ccchunguiuc/ECE445/pcb/445.kicad_pcb

## KiCad design pcb/445.kicad_pcb (2023-05-04)

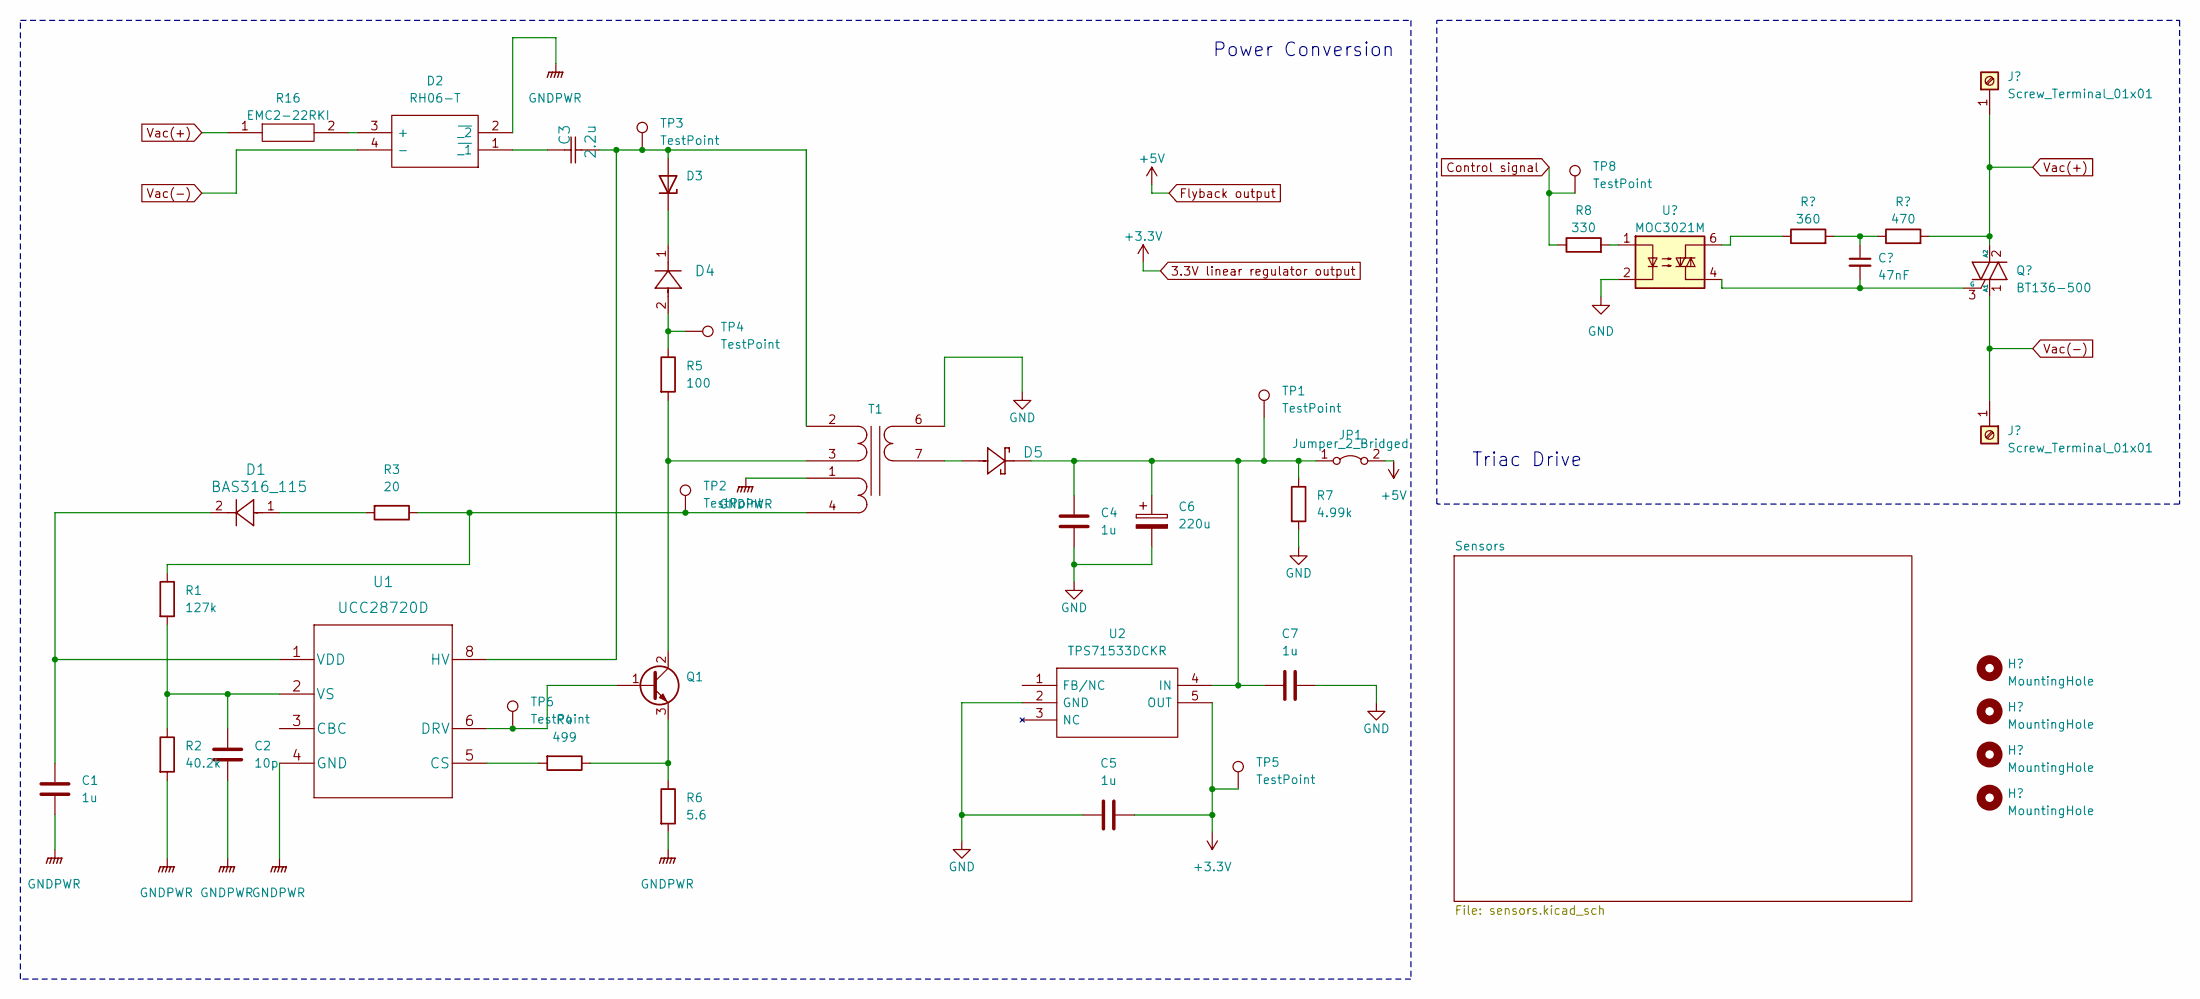
[picture p1: schematic 445.kicad_sch]

Parts:
C1, C4, C5, C7: 1u; C_0603_1608Metric
C2: 10p; R_0603_1608Metric
C3: 2.2u; CKG57NX7T2W225M500JH
C6: 220u; 10TPE220ML
C8: 47nF; C_0603_1608Metric
D1: BAS316_115; SC-76_SOD323_NEX
D2: RH06-T; SOP250P700X300-4N; Mouser Part Number 621-RH06-T
D3: D_Zener; SOD-123_ONS
D4: CGRM4007-G; CGRM
D5: SS110-TP; DO-214AC_SMA_HIGHPROFILE_MCC
H1, H2, H3, H4: MountingHole; MountingHole_3.2mm_M3
J1, J2: Screw_Terminal_01x01; MountingHole_8.0mm_M8_Pad_TopBottom
JP1: Jumper_2_Bridged; R_0603_1608Metric
Q1: Q_NPN_BCE; TO-92L
Q2: BT136-500; TO-220-3_Vertical
R1: 127k; R_0402_1005Metric
R2: 40.2k; R_0603_1608Metric
R3: 20; R_0603_1608Metric
R4: 499; R_0603_1608Metric
R5: 100; R_0805_2012Metric
R6: 5.6; R_0805_2012Metric
R7: 4.99k; R_0603_1608Metric
R8: 330; R_0603_1608Metric
R9: 360; R_0603_1608Metric
R10: 470; R_0603_1608Metric
R16: EMC2-22RKI; RESAD2600W80L1000D400; Mouser Part Number 756-EMC2-22RKI
T1: Transformer_SP_1S; 750813314update
TP1, TP2, TP3, TP4, TP5, TP6, TP8: TestPoint; TestPoint_Loop_D3.80mm_Drill2.0mm
U1: UCC28720D
U2: TPS71533DCKR; SOT65P210X110-5N; Mouser Part Number 595-TPS71533DCKR
U3: MOC3021M; MOC3021

Connections:
3.3V linear regulator output: C5.2, TP5.1, U2.5 (OUT); also elsewhere on the board
Control signal: R8.1, TP8.1; also elsewhere on the board
Flyback output: JP1.2 (B); also elsewhere on the board
GND: C4.2, C5.1, C6.2, C7.2, R7.2, T1.6 (S1), U2.2 (GND), U3.2; also elsewhere on the board
GNDPWR: C1.2, C2.2, D2.2 (~_2), R2.2, R6.2, T1.1 (PR2), U1.4 (GND)
unnamed: C8.1, R9.2, R10.1
unnamed: D1.1 (Input), R3.2
unnamed: C1.1, D1.2 (Output), U1.1 (VDD)
unnamed: D2.3 (+), R16.2
unnamed: C3.2, D2.1 (~_1)
unnamed: C3.1, D3.2 (A), T1.2 (PM), TP3.1, U1.8 (HV)
unnamed 26: D3.1 (K), D4.1; also elsewhere on the board
unnamed 27: D4.2, R5.1, TP4.1; also elsewhere on the board
unnamed: C4.1, C6.1, C7.1, D5.2, JP1.1 (A), R7.1, TP1.1, U2.4 (IN)
unnamed: Q1.1 (B), TP6.1, U1.6 (DRV)
unnamed: Q1.2 (C), R5.2, T1.3 (PR2)
unnamed: Q1.3 (E), R4.1, R6.1
unnamed: C8.2, Q2.3 (G), U3.4
unnamed: R1.1, R3.1, T1.4 (PR2), TP2.1
unnamed: R8.2, U3.1
unnamed: R9.1, U3.6
unnamed: D5.1, T1.7 (S2)
unnamed: R4.2, U1.5 (CS)
unnamed: C2.1, R1.2, R2.1, U1.2 (VS)
Vac(+): J1.1, Q2.2 (A2), R10.2, R16.1
Vac(-): D2.4 (-), J2.1, Q2.1 (A1)

Notes on the sheet:
Triac Drive
Power Conversion

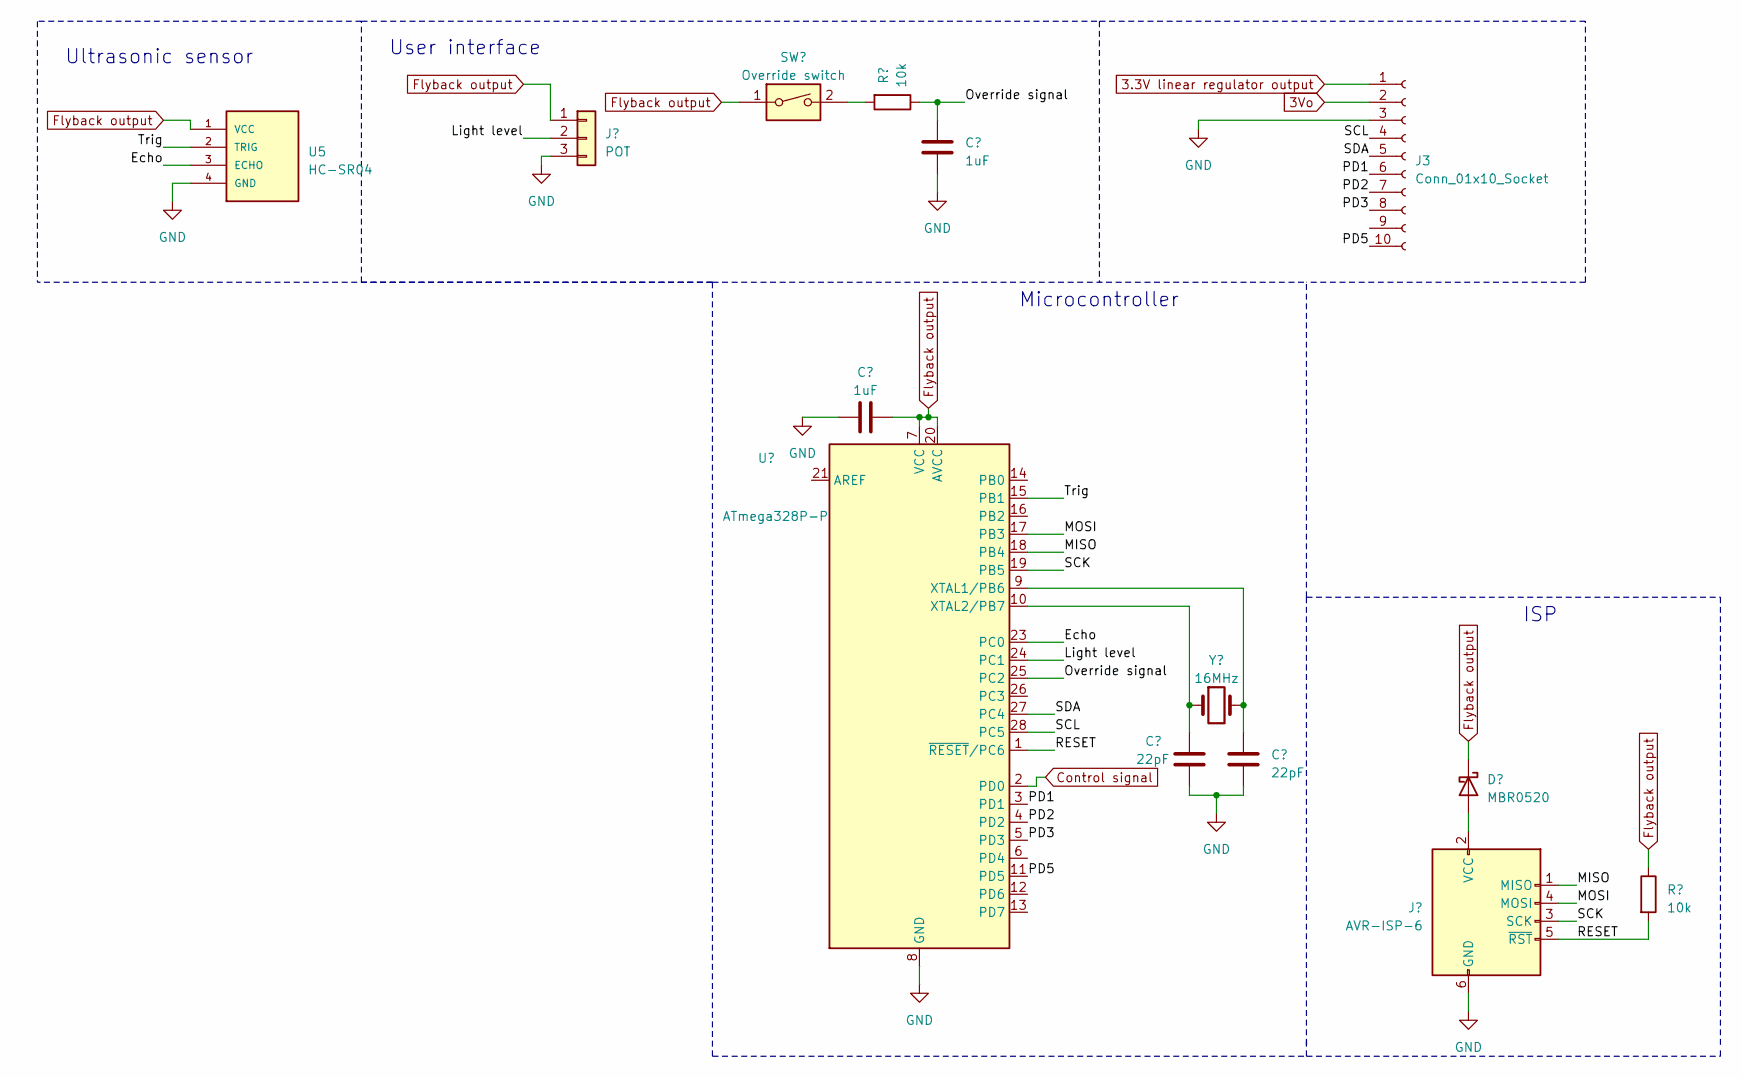
[picture p2: schematic sensors.kicad_sch]

Parts:
C11, C14: 1uF; C_0402_1005Metric
C12, C13: 22pF; C_0805_2012Metric
D6: MBR0520; D_SOD-123
J3: Conn_01x10_Socket; PinSocket_1x10_P2.54mm_Vertical
J4: POT; Molex_KK-254_AE-6410-03A_1x03_P2.54mm_Vertical
J5: AVR-ISP-6; IDC-Header_2x03_P2.54mm_Vertical
R14, R15: 10k; R_0603_1608Metric
SW1: Override switch; SW_SPST_CK_KXT3
U4: ATmega328P-P; DIP-28_W7.62mm
U5: HC-SR04; XCVR_HC-SR04
Y1: 16MHz; Crystal_HC49-U_Vertical

Connections:
3.3V linear regulator output: J3.1; also elsewhere on the board
3Vo: J3.2
/Sensors/Echo: U4.23 (PC0), U5.3 (ECHO)
/Sensors/Light level: J4.2, U4.24 (PC1)
/Sensors/MISO: J5.1 (MISO), U4.18 (PB4)
/Sensors/MOSI: J5.4 (MOSI), U4.17 (PB3)
/Sensors/Override signal: C14.1, R15.1, U4.25 (PC2)
/Sensors/PD1: J3.6, U4.3 (PD1)
/Sensors/PD2: J3.7, U4.4 (PD2)
/Sensors/PD3: J3.8, U4.5 (PD3)
/Sensors/PD5: J3.10, U4.11 (PD5)
/Sensors/RESET: J5.5 (~RST), R14.2, U4.1 (~RESET/PC6)
/Sensors/SCK: J5.3 (SCK), U4.19 (PB5)
/Sensors/SCL: J3.4, U4.28 (PC5)
/Sensors/SDA: J3.5, U4.27 (PC4)
/Sensors/Trig: U4.15 (PB1), U5.2 (TRIG)
Control signal: U4.2 (PD0); also elsewhere on the board
Flyback output: C11.2, D6.1 (K), J4.1, R14.1, SW1.1, U4.7 (VCC), U4.20 (AVCC), U5.1 (VCC); also elsewhere on the board
GND: C11.1, C12.2, C13.2, C14.2, J3.3, J4.3, J5.6 (GND), U4.8 (GND), U4.22 (GND), U5.4 (GND); also elsewhere on the board
unnamed: D6.2 (A), J5.2 (VCC)
unnamed: R15.2, SW1.2
unnamed: C13.1, U4.9 (XTAL1/PB6), Y1.2
unnamed: C12.1, U4.10 (XTAL2/PB7), Y1.1

Notes on the sheet:
ISP
Ultrasonic sensor
User interface
Microcontroller

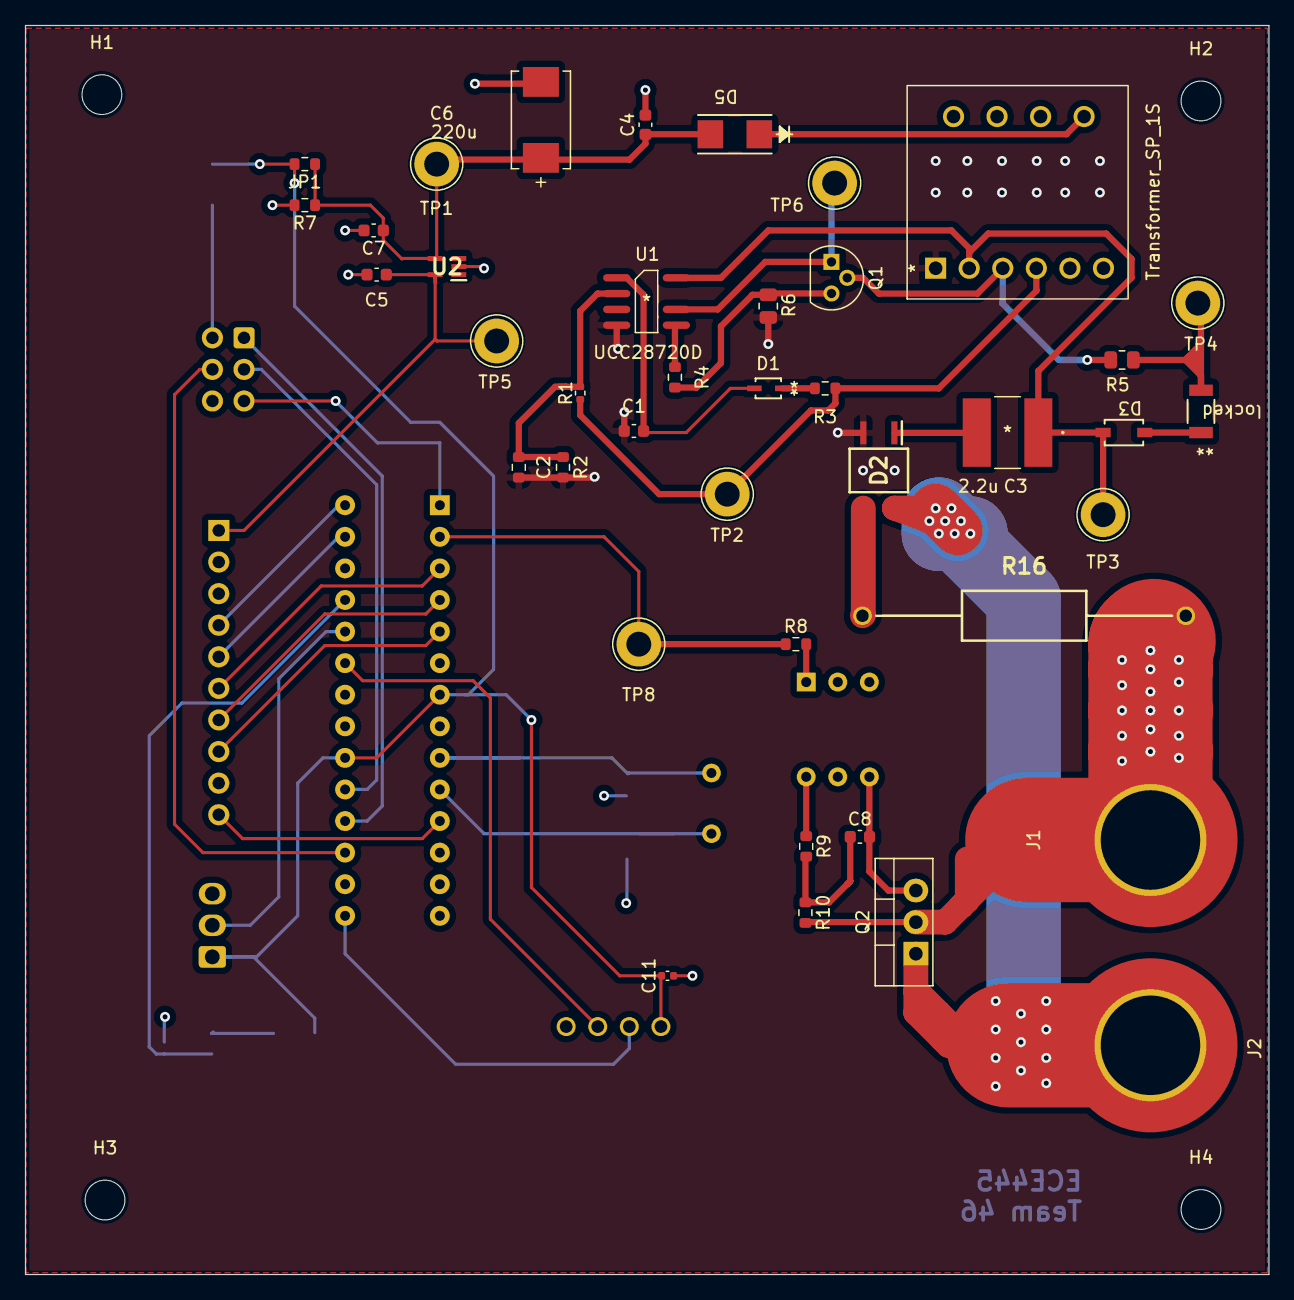
[picture p3: board 445.kicad_pcb from above]

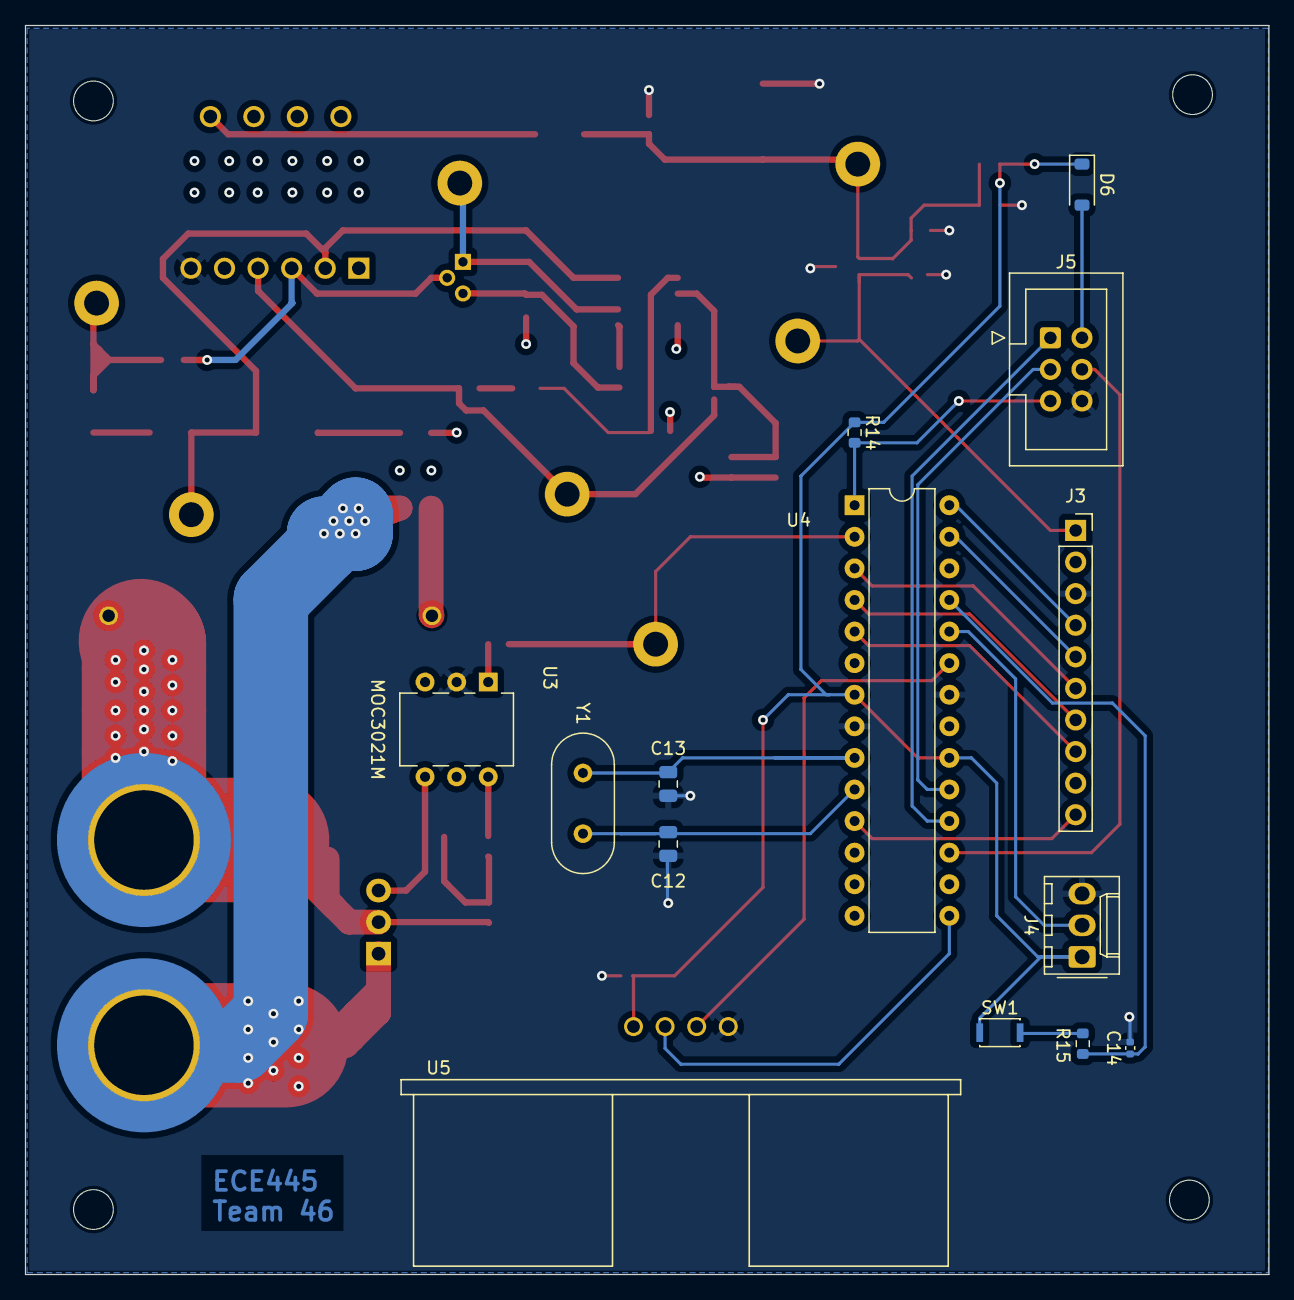
[picture p4: board 445.kicad_pcb from below]

Board: 2 copper layers, 100.0 x 100.4 mm, 58 parts (14 on the bottom side), 44 nets.

Other parts of the board:
locked: CGRM4007-G; CGRM

Their connections:
unnamed 26: locked.1; also elsewhere on the board
unnamed 27: locked.2; also elsewhere on the board
