ccchunguiuc/ECE445/Arduino Code/potentiometer_test/potentiometer_test.ino

<<<<<<< Updated upstream
# define POT_PIN A0
=======
#define POT_PIN A1
>>>>>>> Stashed changes
#define POT_MIN 0
#define POT_MAX 1023

unsigned long previousPotMillis = 0;
const long POT_POLLING_INTERVAL = 100;

float potentiometerStatus = 0;

void setup() {
  // put your setup code here, to run once:
  // pinMode(TEST_PIN, INPUT);

  Serial.begin(9600);
}


void loop() {
  // put your main code here, to run repeatedly:
  pollPotentiometer();


}

void pollPotentiometer() {
  unsigned long currentMillis = millis();
  if (currentMillis - previousPotMillis >= POT_POLLING_INTERVAL) {
    previousPotMillis = currentMillis;
    potentiometerStatus = convertPotentiometerVal();
    Serial.println(potentiometerStatus);
  }    
}

float convertPotentiometerVal(){
  Serial.print("Pot raw value: "); Serial.println(analogRead(POT_PIN));
  return convertInputVal(analogRead(POT_PIN), POT_MIN, POT_MAX);
}

float convertInputVal(float val, float min, float max){
  //converts value from mapping from min-max to mapping from targetMin to targetMax
  float targetMin = 0;
  float targetMax = 1;
  
  if (max-min == 0) {return max;} //check for divide by 0
  
  float convertedVal = (val-min)/(max-min) * (targetMax-targetMin) + targetMin;

  return min(max(convertedVal,0.0),1.0);
}

  
