ccchunguiuc/ECE445/(commit log)

2023-03-07 Add sensors sheet
    [sensors.kicad_sch]
2023-03-07 add power footprints
    [EDI2CAP.CFG, RH06-T.SchLib, RH06-T.stp, SOP250P700X300-4N.PcbLib, SOT65P210X110-5N.PcbLib, TPS71533DCKR.SchLib, TPS71533DCKR.stp, chips.prt]
2023-03-07 File tree restructure
    [EDI2CAP.CFG, RH06-T.SchLib, RH06-T.stp, SOP250P700X300-4N.PcbLib, SOT65P210X110-5N.PcbLib, TPS71533DCKR.SchLib, TPS71533DCKR.stp, chips.prt]
2023-03-07 Add ambient light sensor symbol/footprint
2023-03-07 Restructure symbol and footprint file layout
    [EDI2CAP.CFG, SOT65P210X110-5N.PcbLib, TPS71533DCKR.SchLib, TPS71533DCKR.stp, chips.prt, sot65p210x110-5n.psm]
2023-03-08 custom footprints added
2023-03-08 Add ultrasonic sensor footprint and symbol
2023-03-08 Final schematic before layout
    [445.kicad_sch, sensors.kicad_sch]
2023-03-08 Add fuse symbol and footprint
2023-03-08 Almost done with sensors layout
    [445.kicad_pcb, 445.kicad_sch, sensors.kicad_sch]
2023-03-08 Routing done
    [445.kicad_pcb, 445.kicad_sch]
2023-03-08 Fixing DRC issues
    [445.kicad_pcb]
2023-03-08 Add gerber files
    [445-B_Cu.gbl, 445-B_Fab.gbr, 445-B_Mask.gbs, 445-B_Paste.gbp, 445-B_Silkscreen.gbo, 445-Edge_Cuts.gm1, 445-F_Cu.gtl, 445-F_Fab.gbr]
2023-03-24 Reorganize project folder structure
    [445-B_Cu.gbl, 445-B_Fab.gbr, 445-B_Mask.gbs, 445-B_Paste.gbp, 445-B_Silkscreen.gbo, 445-Edge_Cuts.gm1, 445-F_Cu.gtl, 445-F_Fab.gbr]
2023-03-24 Restructure folder format
    [445-B_Cu.gbl, 445-B_Fab.gbr, 445-B_Mask.gbs, 445-B_Paste.gbp, 445-B_Silkscreen.gbo, 445-Edge_Cuts.gm1, 445-F_Cu.gtl, 445-F_Fab.gbr]
2023-03-25 Arduino test files for ultrasonic and potentiometer added as well as control code draft
2023-03-29 implemented full PID control logic. to be tested
2023-04-14 added tests for luminosity sensor and pid; updated control code
2023-04-18 Add variable pwm square wave
2023-04-18 Trying to make pwm output for control working
2023-04-18 PWM square wave output working
2023-04-18 Increase P_COST for PID control
2023-04-18 Remove testing code for pot/lux sensor
2023-04-20 control code working on arduino
2023-05-04 Restructure project repository
    [445-B_Cu.gbl, 445-B_Fab.gbr, 445-B_Mask.gbs, 445-B_Paste.gbp, 445-B_Silkscreen.gbo, 445-Edge_Cuts.gm1, 445-F_Cu.gtl, 445-F_Fab.gbr]
